DoubleDoo/DEABrain-CW2021/docs/images/4.png

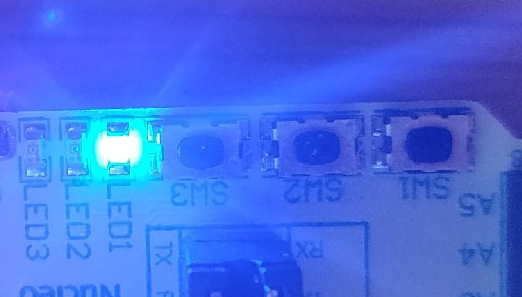
docs/images/4.png
