DoubleDoo/DEABrain-CW2021/docs/images/5.png

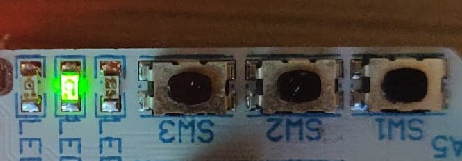
docs/images/5.png
