DoubleDoo/DEABrain-CW2021/README.md

# DEABrain
Hardware and software system for monitoring and processing data of electrical activity of the brain
