DoubleDoo/DEABrain-CW2021/docs/images/11.jpg

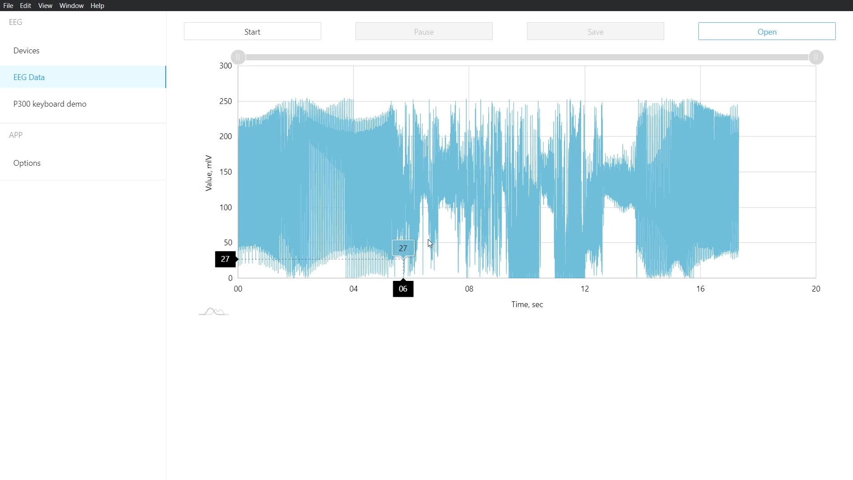
docs/images/11.jpg
