DoubleDoo/DEABrain-CW2021/docs/images/12.jpg

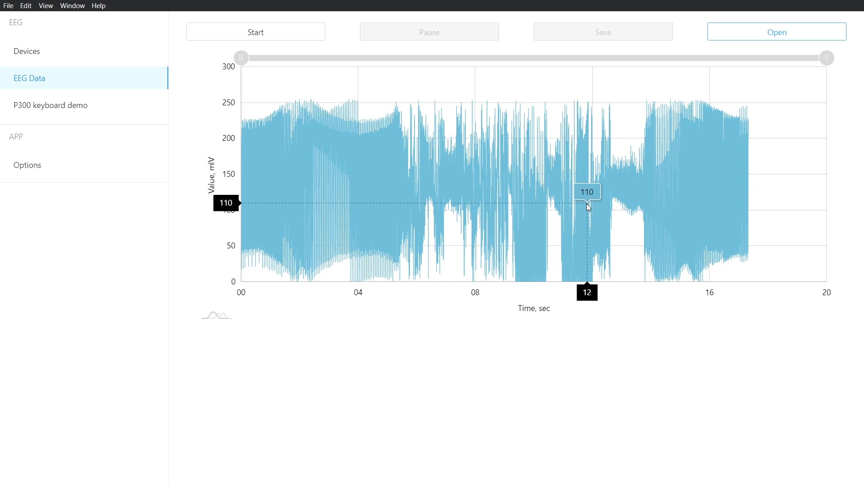
docs/images/12.jpg
