DoubleDoo/DEABrain-CW2021/docs/images/14.jpg

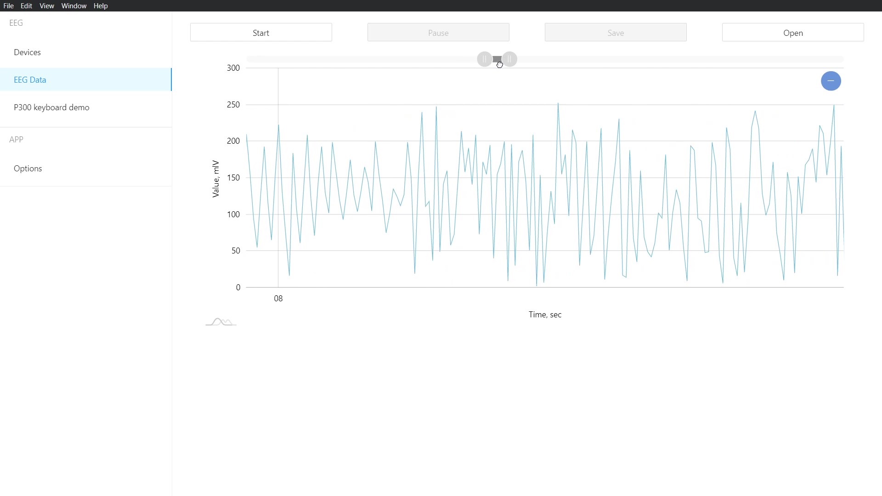
docs/images/14.jpg
