DoubleDoo/DEABrain-CW2021/docs/images/PCB.png

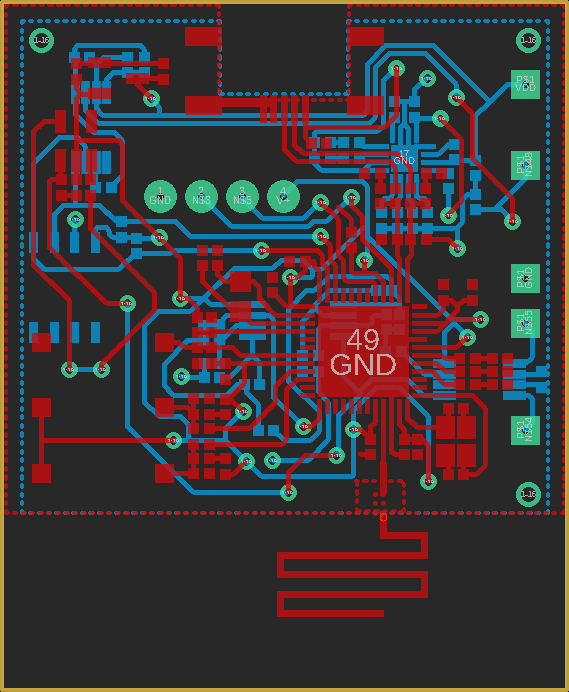
docs/images/PCB.png
