DoubleDoo/DEABrain-CW2021/deviceCase/stl/new-Union.stl

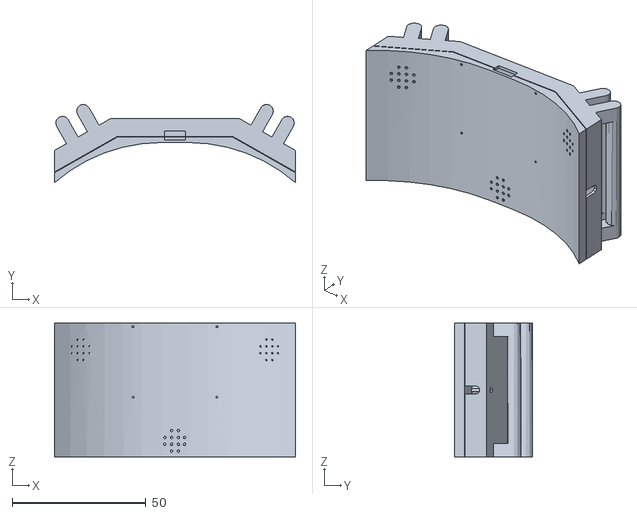
[picture p31: CAD file, 2021-06-11]
deviceCase/stl/new-Union.stl
90.0 x 29.3 x 50.0
