DoubleDoo/DEABrain-CW2021/deviceCase/stl/new-case.stl

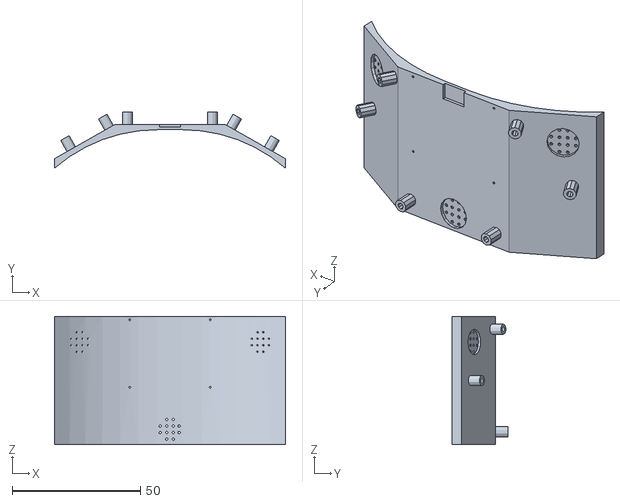
[picture p32: CAD file, 2021-06-09]
deviceCase/stl/new-case.stl
90.0 x 22.0 x 50.0
