DoubleDoo/DEABrain-CW2021/deviceCase/stl/earclip.STL

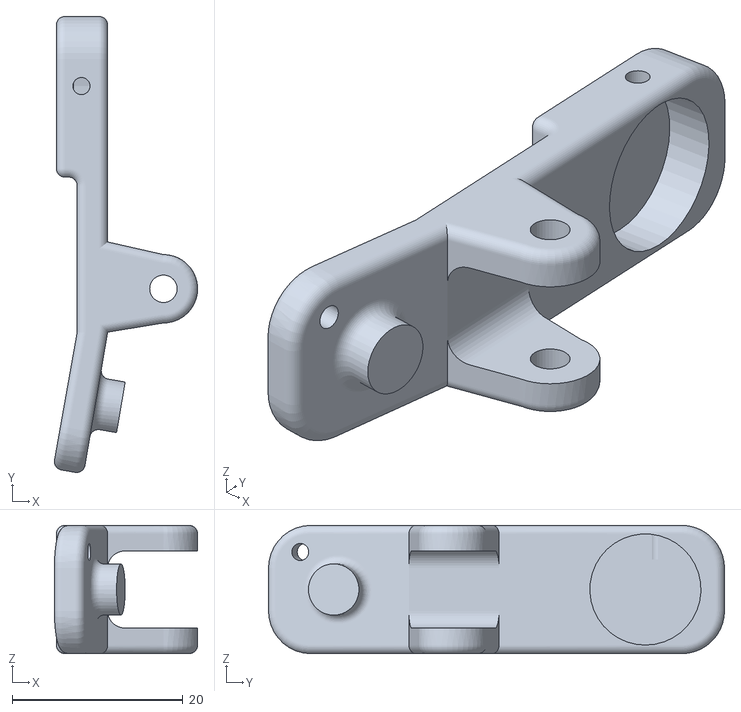
[picture p33: CAD file, 2021-06-09]
deviceCase/stl/earclip.STL
16.8 x 53.3 x 15.0
