DoubleDoo/DEABrain-CW2021/deviceCase/stl/earclip_counterpart.STL

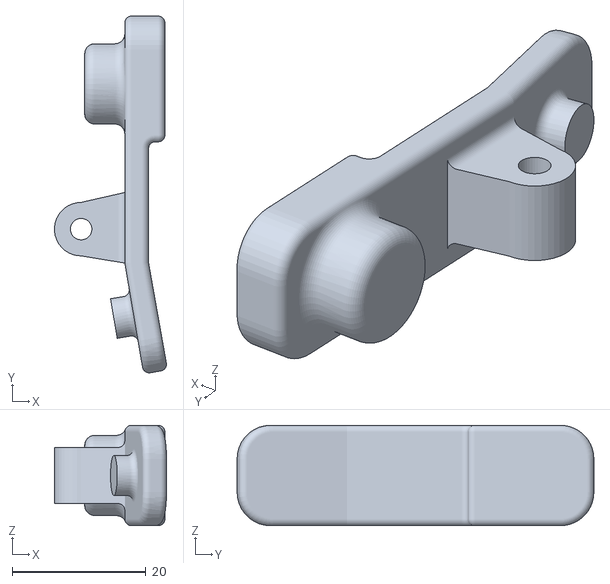
[picture p34: CAD file, 2021-06-09]
deviceCase/stl/earclip_counterpart.STL
16.7 x 53.3 x 15.0
