DoubleDoo/DEABrain-CW2021/deviceCase/stl/new-case2.stl

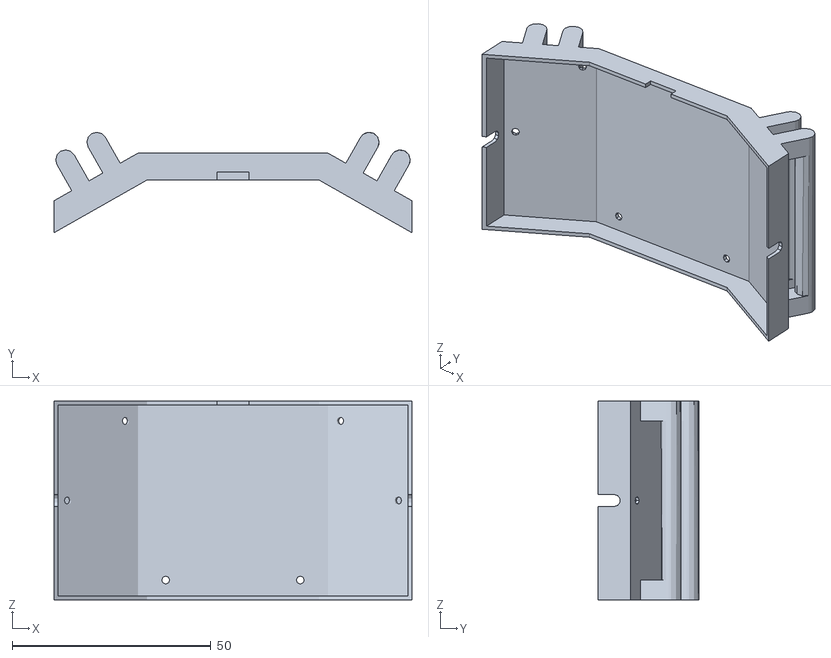
[picture p35: CAD file, 2021-06-09]
deviceCase/stl/new-case2.stl
90.0 x 25.3 x 50.0
