DoubleDoo/DEABrain-CW2021/deviceCase/stl/Union.stl

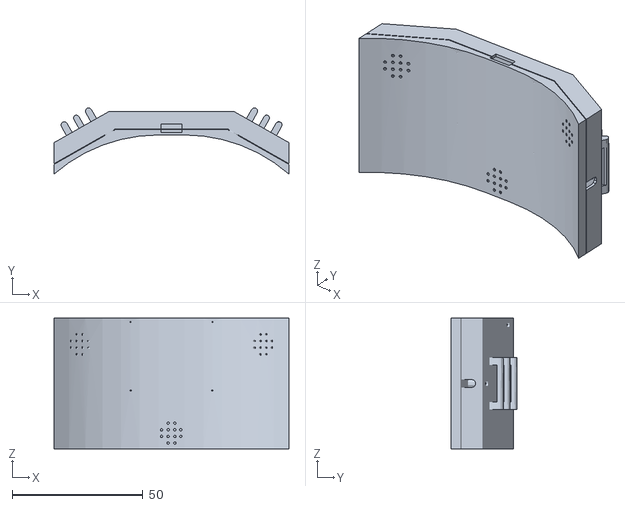
[picture p36: CAD file, 2021-05-22]
deviceCase/stl/Union.stl
90.0 x 25.4 x 50.0
