DoubleDoo/DEABrain-CW2021/deviceCase/stl/case2.stl

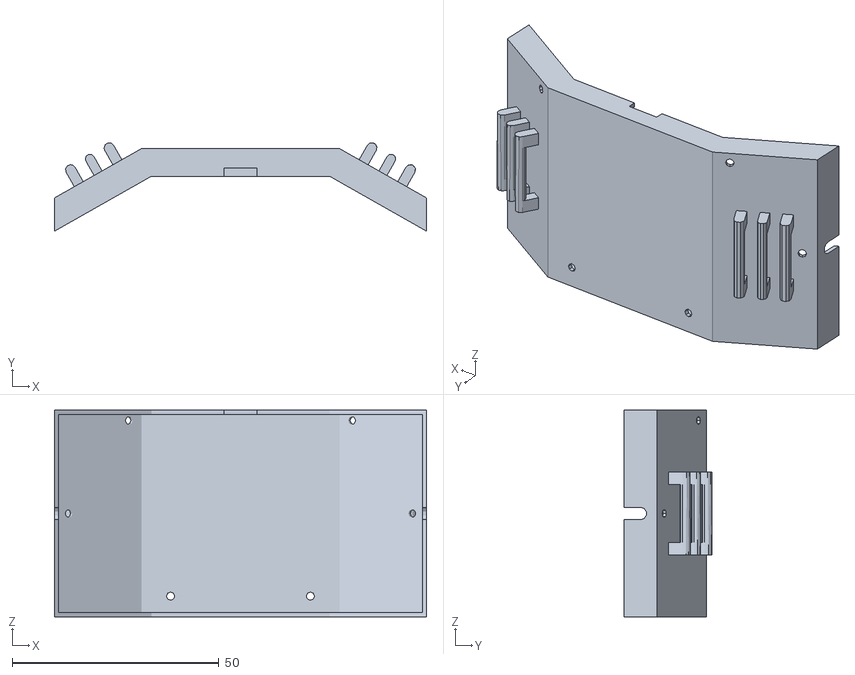
[picture p37: CAD file, 2021-05-22]
deviceCase/stl/case2.stl
90.0 x 21.4 x 50.0
