DoubleDoo/DEABrain-CW2021/(list of files, cad)

Other CAD files:
deviceCase/stl/case.stl
