DoubleDoo/DEABrain-CW2021/Circuit/PreFinal/EEG.brd

## EAGLE design Circuit/PreFinal/EEG.brd (2021-05-21)

Schematic: EEG.sch

Parts:
BOOT, BOOT1: BOOT; C0402
BUTTON1, BUTTON2: BUTTON
B_CAP_1, B_CAP_2: 0.1u; C0402
B_RESET: 1uf; C0402
B_RES_1, B_RES_4: 100om; R0402
B_RES_2, B_RES_5: 220om; R0402
B_RES_3, B_RES_6: 220k; R0402
C1: 10nf; C0402
C2: 4.7uf; C0402
ELECTROD: PIN-1
GBAT: PIN-1
GND: PIN-1
LED_1, LED_2, LED_3: LED; R0402
OSCILLATOR_RF: 32mhz; NX2520SA
OSC_C_1, OSC_C_2: 0; C0402
OSC_RF_C_3, OSC_RF_C_4: 0; C0402
R1: 60k; R0402
R2, R3: 50k; R0402
R4: 3.3k; R0402
R5, R9: 1k; R0402
R6: 0; R0402
R7: 470; R0402
R8: 10-50mO; R0402
R10: 200k; R0402
REF: PIN-1
RES_1_LED, RES_2_LED, RES_3_LED: 680om; R0402
RF_CAP_1, RF_CAP_2: 100pf; C0402
RG: 1Om; R0402
RSCL: 4.7K; R0402
RSDA: 4.7K; R0402
SMPS_C_1: 100nf; C0402
U$1: STM32WB55
U$2, U$6, U$14, U$29, U$30, U$32, U$54: 1uf; C0402
U$3: ANT
U$4: AD8422
U$5: TPS60403
U$7: LM358
U$8: MCP1703
U$9, U$11, U$12, U$13: 330nf; C0402
U$10: MLPF-WB55-01E3DEFAULT; MLPF-WB55-01E3
U$15, U$16: 60k; R0402
U$17, U$18: 9.5k; R0402
U$19, U$20, U$27, U$28: 0; R0402
U$21: M24M01
U$22: USBUSBT; USBT
U$23: SWDSWDD; SWD
U$24: STC3100
U$25: L6924D
U$26: BUTTON
U$31: RESISTORR0402; R0402
U$33: OSC_32KH; RESM2012X60N
U$47, U$48: 1k; R0402
U$49, U$50: LED; R0402
U$55: 220nf; C0402
USB_CAP_0, USB_CAP_1: 47p; C0402
USB_LED_1, USB_LED_2: LED; R0402
USB_LED_RES_1, USB_LED_RES_2: 5k; R0402
USB_RES_0, USB_RES_1: 22om; R0402
VBAT: PIN-1
VDDUSB_CAP_2: 0; C0402
VDD_CAP_1, VDD_CAP_5, VDD_CAP_7: 100nf; C0402
VDD_CAP_6: 4.7 uf; C0402
VDD_CAP_10: 1 uf; C0402

Connections:
GND: BOOT.1, B_RESET.2, B_RES_3.1, B_RES_6.1, C1.1, C2.1, GND.P$1, LED_1.2, LED_2.2, LED_3.2, OSCILLATOR_RF.1 (G1), OSC_C_1.2, OSC_C_2.2, OSC_RF_C_4.2, R1.2, R2.2, R3.2, R4.2, R7.2, R8.2, R10.1, RF_CAP_1.2, RF_CAP_2.2, SMPS_C_1.2, U$1.22 (VSSRF), U$1.32 (VSSSMPS), U$1.49 (VSSRF), U$2.1, U$4.6 (VREF), U$5.4 (GND), U$10.A2 (GND), U$10.B1 (GND), U$10.B2 (GND), U$10.C2 (GND), U$12.1, U$16.2, U$19.1, U$20.2, U$21.1 (E0), U$21.2 (E1), U$21.3 (E2), U$21.4 (GND), U$21.7 (WC), U$22.P$1 (GND), U$22.P$2 (GND), U$22.P$3 (GND), U$22.P$4 (GND), U$22.P$12 (GND), U$23.1 (GND), U$24.5 (GND), U$25.6 (GND), U$25.7 (SD), U$25.9 (VOPRG), U$25.17 (GND), U$26.2 (B2), U$30.1, U$32.1, U$54.1, U$55.2, USB_CAP_0.2, USB_CAP_1.2, USB_LED_1.2, USB_LED_2.2, VDDUSB_CAP_2.2, VDD_CAP_1.1, VDD_CAP_5.2, VDD_CAP_6.1, VDD_CAP_7.1, VDD_CAP_10.1
unnamed: U$1.21 (RF1), U$10.C1 (IN)
unnamed: BOOT.2, BOOT1.2, U$1.4 (BOOT0)
unnamed: U$1.39 (PA13), U$23.2 (SWDIO)
unnamed: OSCILLATOR_RF.2 (O1), OSC_RF_C_4.1, U$1.25 (OSC_IN_2)
unnamed: U$1.41 (PA14), U$23.3 (SWDCLK)
unnamed: RES_1_LED.1, U$1.30 (PE4)
unnamed: U$3.ANT_IN, U$10.A1 (OUT)
unnamed: RES_2_LED.1, U$1.29 (PB1)
unnamed: RES_3_LED.1, U$1.28 (PB0)
unnamed: LED_1.1, RES_1_LED.2
unnamed: LED_2.1, RES_2_LED.2
unnamed: LED_3.1, RES_3_LED.2
unnamed: U$1.37 (PA11), USB_CAP_0.1, USB_LED_RES_2.1, USB_RES_1.1
unnamed: U$1.38 (PA12), USB_CAP_1.1, USB_LED_RES_1.1, USB_RES_0.1
unnamed: R10.2, U$24.2 (ROSC)
unnamed: B_RES_5.2, U$1.9 (PA0)
unnamed: BUTTON1.2 (B2), B_CAP_2.2, B_RES_5.1, B_RES_6.2
unnamed: U$22.P$10 (D+), USB_RES_0.2
unnamed: U$22.P$13 (D-), USB_RES_1.2
unnamed: U$2.2, U$22.P$14 (VBUS), U$25.1 (VIN), U$25.2 (VINSNS), U$47.1, U$48.1
unnamed: R2.1, U$25.15 (IPRG)
unnamed: RSDA.2, U$1.47 (PB7), U$21.5 (SDA), U$24.3 (SDA)
unnamed: B_CAP_2.1, B_RES_4.2
unnamed: B_RES_2.2, U$1.10 (PA1)
unnamed: OSC_C_2.1, U$1.3 (OSC_OUT), U$33.1
unnamed: B_RESET.1, U$1.7 (NRST), U$26.1 (B1), U$31.1
unnamed: OSC_C_1.1, U$1.2 (OSC_IN), U$33.2
unnamed: USB_LED_2.1, USB_LED_RES_2.2
unnamed: OSCILLATOR_RF.3 (G2), OSC_RF_C_3.1
unnamed: C1.2, U$25.5 (TPRG)
unnamed: U$48.2, U$50.1
unnamed: U$47.2, U$49.1
unnamed: R3.1, U$25.16 (VPRE)
unnamed: U$25.3 (ST2), U$49.2
unnamed: U$25.4 (ST1), U$50.2
unnamed: R4.1, U$25.13 (IEND)
unnamed: R1.1, U$25.14 (IPRE)
unnamed: R9.2, U$24.8 (VIN), U$55.1
unnamed: R5.1, R7.1, U$25.8 (TH)
unnamed: R5.2, U$25.12 (VREF)
unnamed: RSCL.2, U$1.46 (PB6), U$21.6 (SCL), U$24.4 (SCL)
unnamed: R6.2, U$25.10 (VOSNS)
unnamed: GBAT.P$1, R8.1, U$24.6 (CG)
unnamed: USB_LED_1.1, USB_LED_RES_1.2
unnamed: RG.2, U$4.2 (RG1)
unnamed: RG.1, U$4.3 (RG2)
unnamed: REF.P$1, U$4.4 (+IN)
unnamed: ELECTROD.P$1, U$4.1 (-IN)
unnamed: U$4.7 (VOUT), U$9.1
unnamed: U$7.1 (O1), U$15.2, U$17.2, U$27.1
unnamed: U$7.3 (I1+), U$11.2, U$16.1
unnamed: U$9.2, U$11.1, U$15.1
unnamed: U$7.2 (I1-), U$19.2, U$27.2
unnamed: U$7.5 (I2+), U$12.2, U$18.1
unnamed: U$13.2, U$17.1, U$18.2
unnamed: U$1.13 (PA4), U$7.7 (O2), U$13.1, U$28.2
unnamed: U$7.6 (I2-), U$20.1, U$28.1
unnamed: BUTTON2.2 (B2), B_CAP_1.2, B_RES_2.1, B_RES_3.2
unnamed: U$6.1, U$8.1 (GND), U$14.1
unnamed: U$5.3 (CFLY-), U$29.1
unnamed: U$5.5 (CFLY+), U$29.2
unnamed: B_CAP_1.1, B_RES_1.2
unnamed: OSCILLATOR_RF.4 (O2), OSC_RF_C_3.2, U$1.24 (OSC_OUT_2)
V+: BOOT1.1, BUTTON1.1 (B1), BUTTON2.1 (B1), B_RES_1.1, B_RES_4.1, RF_CAP_1.1, RF_CAP_2.1, RSCL.1, RSDA.1, SMPS_C_1.1, U$1.1 (VBAT), U$1.8 (VDDA), U$1.20 (VDD), U$1.23 (VDDRF), U$1.31 (VFBSMPS), U$1.33 (VLXSMPS), U$1.34 (VDDSMPS), U$1.35 (VDD_2), U$1.40 (VDDUSB), U$1.48 (VDD_3), U$4.8 (+VS), U$5.2 (IN), U$6.2, U$7.8 (VCC+), U$8.2 (VOUT), U$21.8 (PWR), U$23.4 (PWR), U$31.2, U$32.2, VDDUSB_CAP_2.1, VDD_CAP_1.2, VDD_CAP_5.1, VDD_CAP_6.2, VDD_CAP_7.2, VDD_CAP_10.2
V-: U$4.5 (-VS), U$5.1 (OUT), U$7.4 (VCC-), U$30.2
VDD: C2.2, R6.1, R9.1, U$8.3 (VIN), U$14.2, U$24.7 (VCC), U$25.11 (VOUT), U$54.2, VBAT.P$1

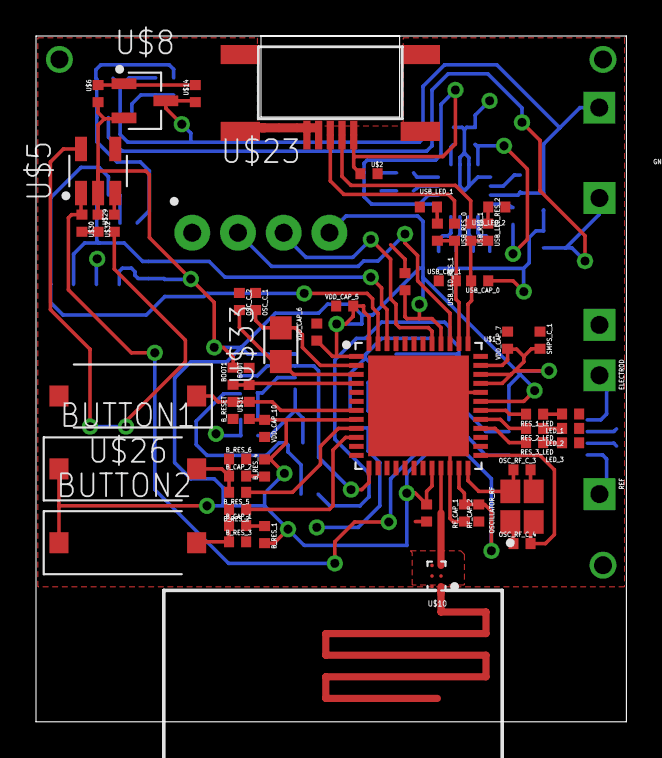
[picture p38: board EEG.brd from above]

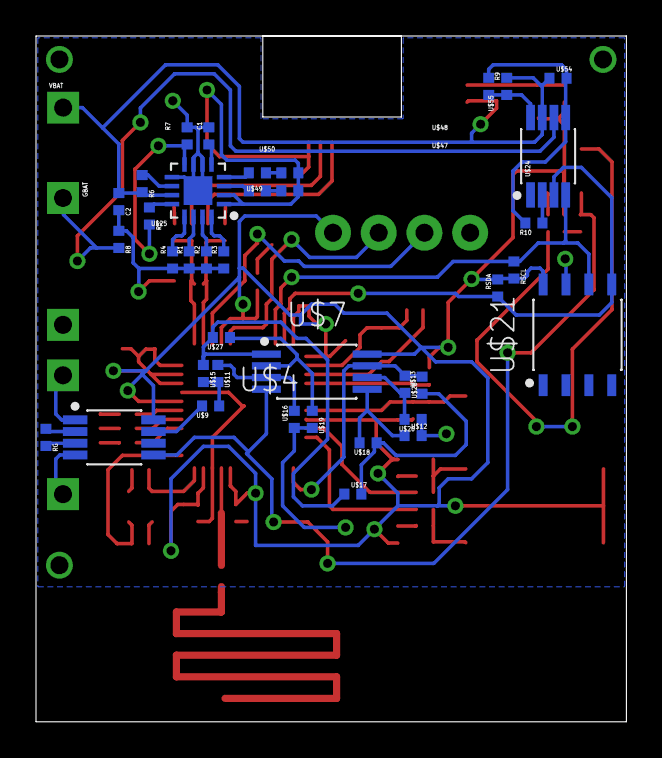
[picture p39: board EEG.brd from below]

Board: 2 copper layers, 32.8 x 38.1 mm, 100 parts (40 on the bottom side), 67 nets.
