DoubleDoo/DEABrain-CW2021/deviceApp/temp/temp.ioc

Mcu.UserName=STM32WB55RGVx
PB6.Signal=USART1_TX
PC4.GPIO_Label=SW1
PB7.Signal=USART1_RX
PB1.Signal=GPIO_Output
PC4.Signal=GPXTI4
PC0.Signal=ADCx_IN1
PC14-OSC32_IN.Signal=RCC_OSC32_IN
PC15-OSC32_OUT.Signal=RCC_OSC32_OUT
PB5.Signal=GPIO_Output
PB0.Signal=GPIO_Output
