DoubleDoo/DEABrain-CW2021/deviceApp/temp/STM32_WPAN/App/custom_stm.c

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

/* Includes ------------------------------------------------------------------*/
#include "common_blesvc.h"
#include "custom_stm.h"

/* USER CODE BEGIN Includes */
#include "main.h"
/* USER CODE END Includes */

typedef struct{
	  /* battery_service */
	  uint8_t               Bval_Notification_Status;
	  /* eeg_service */
	  uint8_t               Val_Notification_Status;
  uint16_t  CustomBservHdle;                   /**< battery_service handle */
  uint16_t  CustomBvalHdle;                   /**< battery_value handle */
  uint16_t  CustomEservHdle;                   /**< eeg_service handle */
  uint16_t  CustomValHdle;                   /**< eeg_value handle */
}CustomContext_t;

#define UUID_128_SUPPORTED  1

#if (UUID_128_SUPPORTED == 1)
#define BM_UUID_LENGTH  UUID_TYPE_128
#else
#define BM_UUID_LENGTH  UUID_TYPE_16
#endif

#define BM_REQ_CHAR_SIZE    (3)

static const uint8_t SizeBval=2;
static const uint8_t SizeVal=2;
/**
 * START of Section BLE_DRIVER_CONTEXT
 */
PLACE_IN_SECTION("BLE_DRIVER_CONTEXT") static CustomContext_t CustomContext;

/**
 * END of Section BLE_DRIVER_CONTEXT
 */

static SVCCTL_EvtAckStatus_t Custom_STM_Event_Handler(void *pckt);

/* Functions Definition ------------------------------------------------------*/

#define COPY_UUID_128(uuid_struct, uuid_15, uuid_14, uuid_13, uuid_12, uuid_11, uuid_10, uuid_9, uuid_8, uuid_7, uuid_6, uuid_5, uuid_4, uuid_3, uuid_2, uuid_1, uuid_0) \
do {\
    uuid_struct[0] = uuid_0; uuid_struct[1] = uuid_1; uuid_struct[2] = uuid_2; uuid_struct[3] = uuid_3; \
        uuid_struct[4] = uuid_4; uuid_struct[5] = uuid_5; uuid_struct[6] = uuid_6; uuid_struct[7] = uuid_7; \
            uuid_struct[8] = uuid_8; uuid_struct[9] = uuid_9; uuid_struct[10] = uuid_10; uuid_struct[11] = uuid_11; \
                uuid_struct[12] = uuid_12; uuid_struct[13] = uuid_13; uuid_struct[14] = uuid_14; uuid_struct[15] = uuid_15; \
}while(0)

/* Hardware Characteristics Service */
/*
 The following 128bits UUIDs have been generated from the random UUID
 generator:
 D973F2E0-B19E-11E2-9E96-0800200C9A66: Service 128bits UUID
 D973F2E1-B19E-11E2-9E96-0800200C9A66: Characteristic_1 128bits UUID
 D973F2E2-B19E-11E2-9E96-0800200C9A66: Characteristic_2 128bits UUID
 */

/**
 * @brief  Event handler
 * @param  Event: Address of the buffer holding the Event
 * @retval Ack: Return whether the Event has been managed or not
 */
static SVCCTL_EvtAckStatus_t Custom_STM_Event_Handler(void *Event)
{
  SVCCTL_EvtAckStatus_t return_value;
  hci_event_pckt *event_pckt;
  evt_blecore_aci *blecore_evt;
/* USER CODE BEGIN Custom_STM_Event_Handler_1 */
  aci_gatt_attribute_modified_event_rp0    * attribute_modified;
  Custom_STM_App_Notification_evt_t  Notification;
/* USER CODE END Custom_STM_Event_Handler_1 */

  return_value = SVCCTL_EvtNotAck;
  event_pckt = (hci_event_pckt *)(((hci_uart_pckt*)Event)->data);

  switch(event_pckt->evt)
  {
    case HCI_VENDOR_SPECIFIC_DEBUG_EVT_CODE:
      blecore_evt = (evt_blecore_aci*)event_pckt->data;
      switch(blecore_evt->ecode)
      {

        case ACI_GATT_ATTRIBUTE_MODIFIED_VSEVT_CODE:
          /* USER CODE BEGIN EVT_BLUE_GATT_ATTRIBUTE_MODIFIED */
        	attribute_modified = (aci_gatt_attribute_modified_event_rp0*)blecore_evt->data;
        	if(attribute_modified->Attr_Handle == 16)
        	{
        		return_value = SVCCTL_EvtAckFlowEnable;
        		if (CustomContext.Bval_Notification_Status==1){
        			CustomContext.Bval_Notification_Status=0;
        			Notification.Custom_Evt_Opcode = CUSTOM_STM_BVAL_NOTIFY_DISABLED_EVT;
        			Custom_STM_App_Notification(&Notification);
        		}
        		else{
        			CustomContext.Bval_Notification_Status=1;
        			Notification.Custom_Evt_Opcode = CUSTOM_STM_BVAL_NOTIFY_ENABLED_EVT;
        			Custom_STM_App_Notification(&Notification);
        		}
        	}
        	else if(attribute_modified->Attr_Handle ==21)
        	{
        		return_value = SVCCTL_EvtAckFlowEnable;
        		if (CustomContext.Val_Notification_Status==1){
        			CustomContext.Val_Notification_Status=0;
        			Notification.Custom_Evt_Opcode = CUSTOM_STM_VAL_NOTIFY_DISABLED_EVT;
        			Custom_STM_App_Notification(&Notification);
        		}
        		else{
        			CustomContext.Val_Notification_Status=1;
        			Notification.Custom_Evt_Opcode = CUSTOM_STM_VAL_NOTIFY_ENABLED_EVT;
        			Custom_STM_App_Notification(&Notification);
        		}
        	}
        	else if(attribute_modified->Attr_Handle ==4)
        	{
    			Notification.Custom_Evt_Opcode = CUSTOM_STM_BVAL_READ_EVT;
    			Custom_STM_App_Notification(&Notification);
        	}
        	else if(attribute_modified->Attr_Handle ==9)
        	{
        		Notification.Custom_Evt_Opcode = CUSTOM_STM_VAL_READ_EVT;
        		Custom_STM_App_Notification(&Notification);
        	}
        	else{
        		for(uint8_t i=0;i<=attribute_modified->Attr_Handle;i++){
        		    HAL_GPIO_WritePin(GPIOB, GPIO_PIN_5,GPIO_PIN_SET);
        		    HAL_Delay(500);
        		    HAL_GPIO_WritePin(GPIOB, GPIO_PIN_5,GPIO_PIN_RESET);
        			HAL_Delay(500);
        		}
        		HAL_GPIO_WritePin(GPIOB, GPIO_PIN_5,GPIO_PIN_SET);
        		HAL_Delay(2000);
        		HAL_GPIO_WritePin(GPIOB, GPIO_PIN_5,GPIO_PIN_RESET);
        	}

          /* USER CODE END EVT_BLUE_GATT_ATTRIBUTE_MODIFIED */
          break;
        case ACI_GATT_READ_PERMIT_REQ_VSEVT_CODE :
          /* USER CODE BEGIN EVT_BLUE_GATT_READ_PERMIT_REQ */
        	attribute_modified = (aci_gatt_attribute_modified_event_rp0*)blecore_evt->data;
        	if(attribute_modified->Attr_Handle == 14)
        	{
    			Notification.Custom_Evt_Opcode = CUSTOM_STM_BVAL_READ_EVT;
    			Custom_STM_App_Notification(&Notification);
        	}
        	else if(attribute_modified->Attr_Handle ==19)
        	{
        		Notification.Custom_Evt_Opcode = CUSTOM_STM_VAL_READ_EVT;
        		Custom_STM_App_Notification(&Notification);
        	}
        	else{
        		for(uint8_t i=0;i<=attribute_modified->Attr_Handle;i++){
        		    HAL_GPIO_WritePin(GPIOB, GPIO_PIN_5,GPIO_PIN_SET);
        		    HAL_Delay(500);
        		    HAL_GPIO_WritePin(GPIOB, GPIO_PIN_5,GPIO_PIN_RESET);
        			HAL_Delay(500);
        		}
        		HAL_GPIO_WritePin(GPIOB, GPIO_PIN_5,GPIO_PIN_SET);
        		HAL_Delay(2000);
        		HAL_GPIO_WritePin(GPIOB, GPIO_PIN_5,GPIO_PIN_RESET);
        	}
    		//14 bat
    		//19 heart
          /* USER CODE END EVT_BLUE_GATT_READ_PERMIT_REQ */
          break;
        case ACI_GATT_WRITE_PERMIT_REQ_VSEVT_CODE:
          /* USER CODE BEGIN EVT_BLUE_GATT_WRITE_PERMIT_REQ */
        	attribute_modified = (aci_gatt_attribute_modified_event_rp0*)blecore_evt->data;
    		for(uint8_t i=0;i<=attribute_modified->Attr_Handle;i++){
    		    HAL_GPIO_WritePin(GPIOB, GPIO_PIN_5,GPIO_PIN_SET);
    		    HAL_Delay(500);
    		    HAL_GPIO_WritePin(GPIOB, GPIO_PIN_5,GPIO_PIN_RESET);
    			HAL_Delay(500);
    		}
    		HAL_GPIO_WritePin(GPIOB, GPIO_PIN_5,GPIO_PIN_SET);
    		HAL_Delay(2000);
    		HAL_GPIO_WritePin(GPIOB, GPIO_PIN_5,GPIO_PIN_RESET);
          /* USER CODE END EVT_BLUE_GATT_WRITE_PERMIT_REQ */
          break;

        default:
          break;
      }
      /* USER CODE BEGIN EVT_VENDOR*/

      /* USER CODE END EVT_VENDOR*/
      break; /* HCI_VENDOR_SPECIFIC_DEBUG_EVT_CODE */

    /* USER CODE BEGIN EVENT_PCKT_CASES*/

    /* USER CODE END EVENT_PCKT_CASES*/

    default:
      break;
  }

  return(return_value);
}/* end Custom_STM_Event_Handler */

/* Public functions ----------------------------------------------------------*/

/**
 * @brief  Service initialization
 * @param  None
 * @retval None
 */
void SVCCTL_InitCustomSvc(void)
{

  Char_UUID_t  uuid;
/* USER CODE BEGIN SVCCTL_InitCustomSvc_1 */
  CustomContext.Bval_Notification_Status=0;
  CustomContext.Val_Notification_Status=0;
//  CustomContext.CustomValHdle=0;
//  CustomContext.CustomEservHdle=0;
//  CustomContext.CustomBvalHdle=0;
//  CustomContext.CustomBservHdle=0;
/* USER CODE END SVCCTL_InitCustomSvc_1 */

  /**
   *	Register the event handler to the BLE controller
   */
  SVCCTL_RegisterSvcHandler(Custom_STM_Event_Handler);

    /*
     *          battery_service
     *
     * Max_Attribute_Records = 1 + 2*1 + 1*no_of_char_with_notify_or_indicate_property + 1*no_of_char_with_broadcast_property
     * service_max_attribute_record = 1 for battery_service +
     *                                2 for battery_value +
     *                                1 for battery_value configuration descriptor +
     *                                1 for battery_value broadcast property +
     *                              = 5
     */

    uuid.Char_UUID_16 = 0x180f;
    aci_gatt_add_service(UUID_TYPE_16,
                      (Service_UUID_t *) &uuid,
                      PRIMARY_SERVICE,
                      5,
                      &(CustomContext.CustomBservHdle));

    /**
     *  battery_value
     */
    uuid.Char_UUID_16 = 0x2a19;
    aci_gatt_add_char(CustomContext.CustomBservHdle,
                      UUID_TYPE_16, &uuid,
                      SizeBval,
                      CHAR_PROP_BROADCAST | CHAR_PROP_READ | CHAR_PROP_NOTIFY,
                      ATTR_PERMISSION_NONE,
                      GATT_DONT_NOTIFY_EVENTS,
                      0x10,
                      CHAR_VALUE_LEN_CONSTANT,
                      &(CustomContext.CustomBvalHdle));

    /*
     *          eeg_service
     *
     * Max_Attribute_Records = 1 + 2*1 + 1*no_of_char_with_notify_or_indicate_property + 1*no_of_char_with_broadcast_property
     * service_max_attribute_record = 1 for eeg_service +
     *                                2 for eeg_value +
     *                                1 for eeg_value configuration descriptor +
     *                                1 for eeg_value broadcast property +
     *                              = 5
     */

    uuid.Char_UUID_16 = 0x180d;
    aci_gatt_add_service(UUID_TYPE_16,
                      (Service_UUID_t *) &uuid,
                      PRIMARY_SERVICE,
                      5,
                      &(CustomContext.CustomEservHdle));

    /**
     *  eeg_value
     */
    uuid.Char_UUID_16 = 0x2a37;
    aci_gatt_add_char(CustomContext.CustomEservHdle,
                      UUID_TYPE_16, &uuid,
                      SizeVal,
                      CHAR_PROP_BROADCAST | CHAR_PROP_READ | CHAR_PROP_NOTIFY,
                      ATTR_PERMISSION_NONE,
                      GATT_DONT_NOTIFY_EVENTS,
                      0x10,
                      CHAR_VALUE_LEN_CONSTANT,
                      &(CustomContext.CustomValHdle));

  return;
}

/**
 * @brief  Characteristic update
 * @param  CharOpcode: Characteristic identifier
 * @param  Service_Instance: Instance of the service to which the characteristic belongs
 *
 */
tBleStatus Custom_STM_App_Update_Char(Custom_STM_Char_Opcode_t CharOpcode, uint8_t *pPayload)
{
  tBleStatus result = BLE_STATUS_INVALID_PARAMS;
  switch(CharOpcode)
  {

    case CUSTOM_STM_BVAL:
      result = aci_gatt_update_char_value(CustomContext.CustomBservHdle,
                            CustomContext.CustomBvalHdle,
                            0, /* charValOffset */
                            SizeBval, /* charValueLen */
                            (uint8_t *)  pPayload);
    /* USER CODE BEGIN CUSTOM_STM_BVAL*/
      if(result!=0x00) HAL_GPIO_WritePin(GPIOB, GPIO_PIN_5,GPIO_PIN_SET);
    /* USER CODE END CUSTOM_STM_BVAL*/
      break;

    case CUSTOM_STM_VAL:
      result = aci_gatt_update_char_value(CustomContext.CustomEservHdle,
                            CustomContext.CustomValHdle,
                            0, /* charValOffset */
                            SizeVal, /* charValueLen */
                            (uint8_t *)  pPayload);
    /* USER CODE BEGIN CUSTOM_STM_VAL*/

    /* USER CODE END CUSTOM_STM_VAL*/
      break;

    default:
      break;
  }

  return result;
}

/************************ (C) COPYRIGHT STMicroelectronics *****END OF FILE****/
