DoubleDoo/DEABrain-CW2021/deviceApp/temp/Core/Src/stm32wbxx_it.c

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

/* Includes ------------------------------------------------------------------*/
#include "main.h"
#include "stm32wbxx_it.h"
/* USER CODE BEGIN Includes */
#include "app_common.h"

/* USER CODE END Includes */

/* External variables --------------------------------------------------------*/
extern DMA_HandleTypeDef hdma_usart1_tx;
/******************************************************************************/
/*           Cortex Processor Interruption and Exception Handlers          */
/******************************************************************************/
/**
  * @brief This function handles Non maskable interrupt.
  */
void NMI_Handler(void)
{
  /* USER CODE BEGIN NonMaskableInt_IRQn 1 */
  while (1)
  {
  }
  /* USER CODE END NonMaskableInt_IRQn 1 */
}

/**
  * @brief This function handles Hard fault interrupt.
  */
void HardFault_Handler(void)
{
  while (1)
  {
  }
}

/**
  * @brief This function handles Memory management fault.
  */
void MemManage_Handler(void)
{
  while (1)
  {
  }
}

/**
  * @brief This function handles Prefetch fault, memory access fault.
  */
void BusFault_Handler(void)
{
  while (1)
  {
  }
}

/**
  * @brief This function handles Undefined instruction or illegal state.
  */
void UsageFault_Handler(void)
{
  while (1)
  {
  }
}

/**
  * @brief This function handles System service call via SWI instruction.
  */
void SVC_Handler(void)
{
}

/**
  * @brief This function handles Debug monitor.
  */
void DebugMon_Handler(void)
{
}

/**
  * @brief This function handles Pendable request for system service.
  */
void PendSV_Handler(void)
{
}

/**
  * @brief This function handles System tick timer.
  */
void SysTick_Handler(void)
{
  HAL_IncTick();
}

/******************************************************************************/
/* STM32WBxx Peripheral Interrupt Handlers                                    */
/* Add here the Interrupt Handlers for the used peripherals.                  */
/* For the available peripheral interrupt handler names,                      */
/* please refer to the startup file (startup_stm32wbxx.s).                    */
/******************************************************************************/

/**
  * @brief This function handles EXTI line4 interrupt.
  */
void EXTI4_IRQHandler(void)
{
  HAL_GPIO_EXTI_IRQHandler(GPIO_PIN_4);
}

/**
  * @brief This function handles HSEM global interrupt.
  */
void HSEM_IRQHandler(void)
{
  HAL_HSEM_IRQHandler();
}

/**
  * @brief This function handles DMA2 channel4 global interrupt.
  */
void DMA2_Channel4_IRQHandler(void)
{
  HAL_DMA_IRQHandler(&hdma_usart1_tx);
}

/* USER CODE BEGIN 1 */
/**

* @brief This function handles RTC wake-up interrupt through EXTI line 19.

*/

void RTC_WKUP_IRQHandler(void)

{

HW_TS_RTC_Wakeup_Handler();

}

/**

* @brief This function handles IPCC RX occupied interrupt.

*/

void IPCC_C1_RX_IRQHandler(void)

{

HW_IPCC_Rx_Handler();

}

/**

* @brief This function handles IPCC TX free interrupt.

*/

void IPCC_C1_TX_IRQHandler(void)

{

HW_IPCC_Tx_Handler();

}
/* USER CODE END 1 */
/************************ (C) COPYRIGHT STMicroelectronics *****END OF FILE****/
