DoubleDoo/DEABrain-CW2021/(commit log)

2020-11-08 Circuits and Resources commit
    [untitled.brd, untitled.sch]
2021-02-03 board development
    [EEG.brd, EEG.sch]
2021-04-08 Add app prototype
    [EEG.brd]
2021-04-11 app development, add test EEG data
    [Data1.csv, Data10.csv, Data2.csv, Data3.csv, Data4.csv, Data5.csv, Data6.csv, Data7.csv]
2021-04-12 rebuild react app
    [Data1.csv, Data10.csv, Data2.csv, Data3.csv, Data4.csv, Data5.csv, Data6.csv, Data7.csv]
2021-04-14 add test EEG data, add data simulation send, and chart prototypes
    [Data1.csv, Data10.csv, Data2.csv, Data3.csv, Data4.csv, Data5.csv, Data6.csv, Data7.csv]
2021-04-18 options add, test py model add
    [Data1.csv, Data10.csv, Data2.csv, Data3.csv, Data4.csv, Data5.csv, Data6.csv, Data7.csv]
2021-04-22 docs and net development
    [Y.csv]
2021-05-21 update data
    [EEG.brd]
2021-05-21 data upd
    [TrainLabels.csv, Y.csv]
2021-05-22 document "Текст программы" development
2021-05-22 add case models, docs development
    [Union.stl, case.stl, case2.stl]
2021-05-26 "Руководство оператора" finished
2021-06-09 last update
    [earclip.STL, earclip_counterpart.STL, new-case.stl, new-case2.stl]
